fedcr/SmartCurtain/BOM.md

# SmartCurtain - Enclosure and Mechanical Transmission – bill of materials

<!-- Generated by Half Life from project cmv53qt9g0gqx01n0q0fv1dz5. Edits here are overwritten on the next sync. -->
<!-- Generated: 1970-01-01T00:00:00.000Z -->

> [!NOTE]
> This parts list is mirrored from [Half Life](https://halflife.hackclub.com). Editing it here will not change the platform's copy, and the next sync overwrites this file.

| Week | Tier | Parts funding |
| --- | --- | --- |
| Week 2 | Tier 1 | $30.00 |

_No parts listed yet._
