fedcr/SmartCurtain/BOM.csv

Item | Qty | Supplier | Cost/item | Total Cost | link
C3 | 1 |  | $2.09 | $2.09
C4 | 1 |  | $1.84 | $1.84
C5 | 1 |  | $0.00 | $0.00
C6 | 1 |  | $0.00 | $0.00
D1 | 1 |  | $1.32 | $1.32
J1 | 1 |  | $3.40 | $3.40
J2 | 1 |  | $3.67 | $3.67
J3 | 1 |  | $2.49 | $2.49
J5 | 1 |  | $2.81 | $2.81
LuceClima1 | 1 |  | $0.00 | $0.00
Q1 | 1 |  | $1.73 | $1.73
R2 | 1 |  | $1.88 | $1.88
R3 | 1 |  | $3.25 | $3.25
R4 | 1 |  | $0.00 | $0.00
R5 | 1 |  | $0.00 | $0.00
R6 | 1 |  | $0.00 | $0.00
R7 | 1 |  | $0.00 | $0.00
R8 | 1 |  | $0.00 | $0.00
RadarmmWave1 | 1 |  | $0.00 | $0.00
SW1 | 1 |  | $2.65 | $2.65
U1 | 1 |  | $5.86 | $5.86
U2 | 1 |  | $6.24 | $6.24
U3 | 1 |  | $4.29 | $4.29
U4 | 1 |  | $1.71 | $1.71
M1 | 1 |  | $8.00 | $8.00
PCB | 1 |  | $3.57 | $3.57
Estimated total shipping | 1 |  |  | $70.11
