fedcr/SmartCurtain/File STL/bracket4.stl

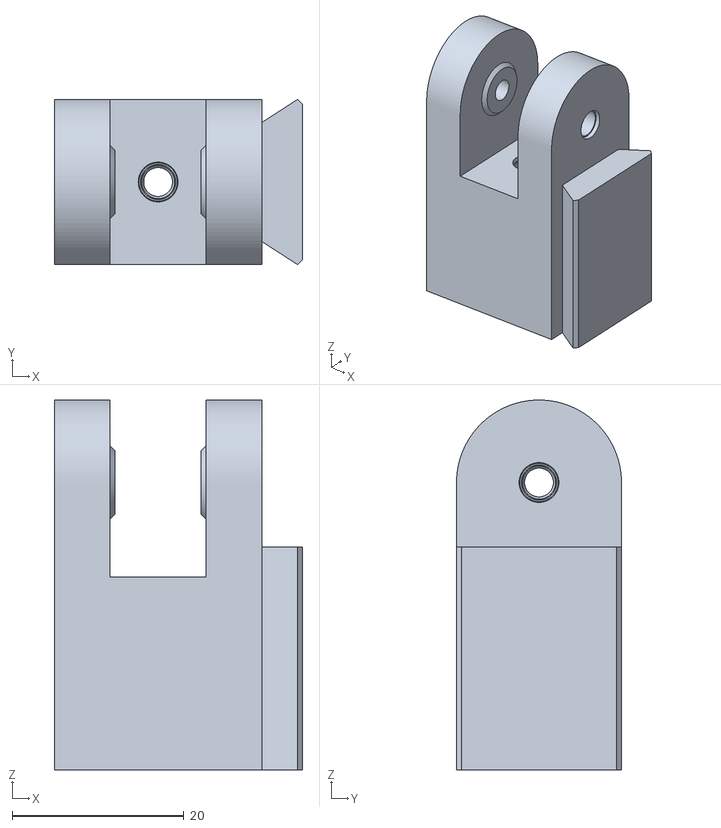
[picture p1: CAD file, 2026-10-14]
File STL/bracket4.stl
28.9 x 19.2 x 43.1
