fedcr/SmartCurtain/PCB/PCB.stl

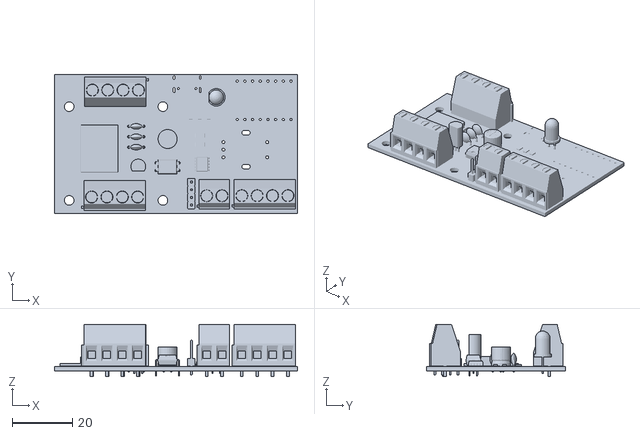
[picture p2: CAD file, 2026-10-21]
PCB/PCB.stl
80.4 x 46.0 x 17.3
