fedcr/SmartCurtain/Print Files/STL/smartcurtain_idler_sleeve.stl

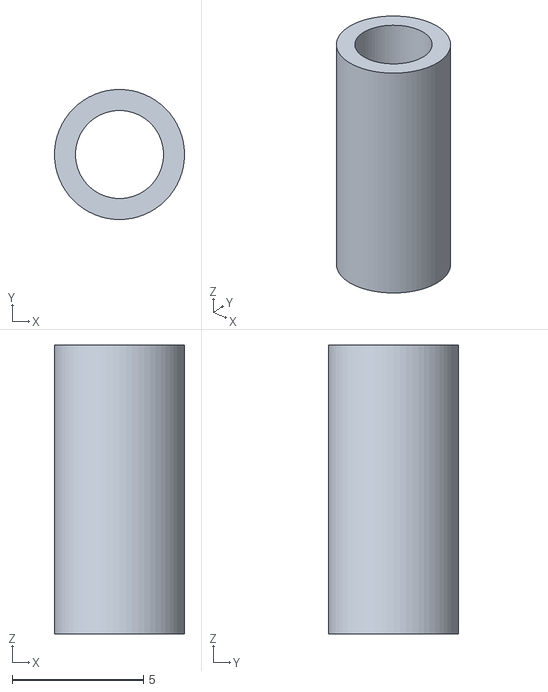
[picture p3: CAD file, 2026-10-21]
Print Files/STL/smartcurtain_idler_sleeve.stl
4.95 x 4.95 x 11.0
