fedcr/SmartCurtain/File STL/bracket1.stl

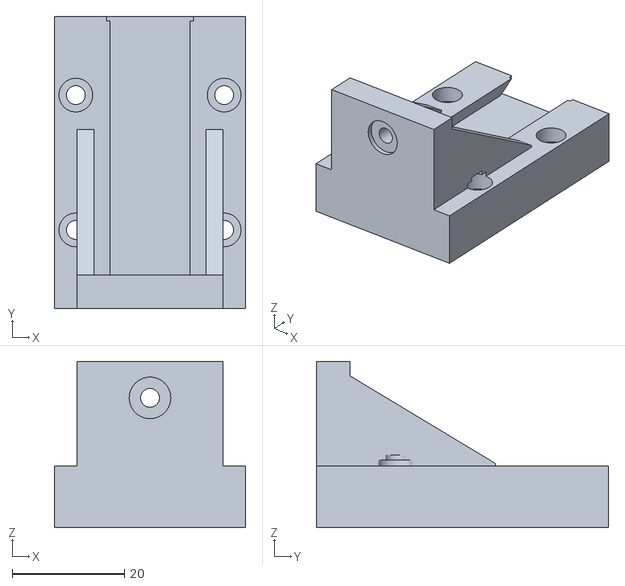
[picture p4: CAD file, 2026-10-14]
File STL/bracket1.stl
34.0 x 52.0 x 29.6
