fedcr/SmartCurtain/Print Files/STL/smartcurtain_trolley.stl

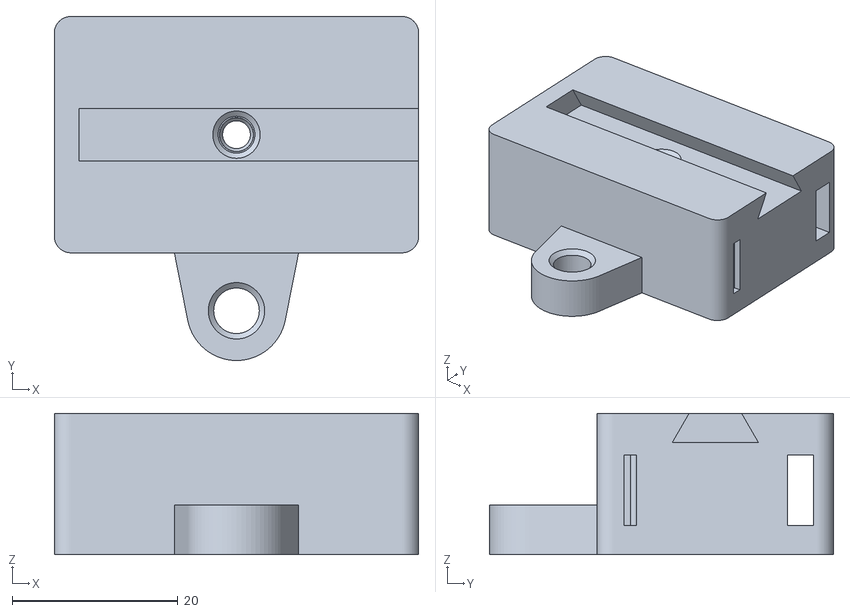
[picture p5: CAD file, 2026-10-21]
Print Files/STL/smartcurtain_trolley.stl
44.0 x 41.5 x 17.0
