fedcr/SmartCurtain/File STL/file puleggia.3mf

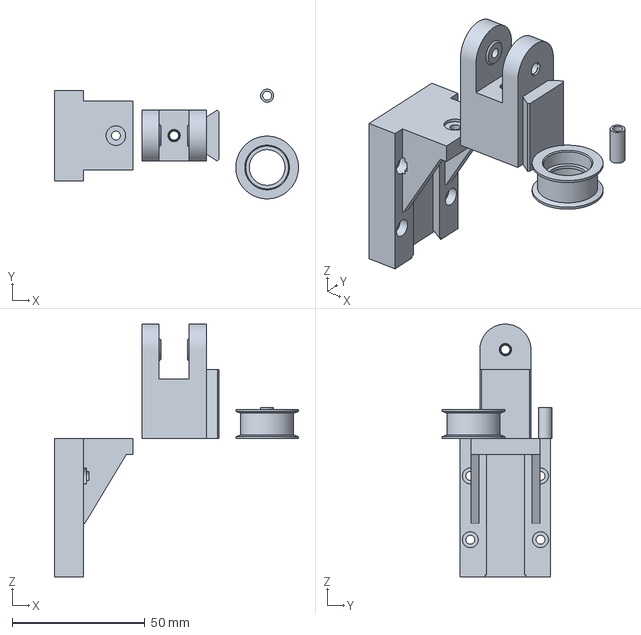
[picture p6: CAD file, 2026-10-14]
File STL/file puleggia.3mf
91.8 x 41.3 x 95.1 mm
