fedcr/SmartCurtain/Print Files/STL/smartcurtain_mmwave_mount.stl

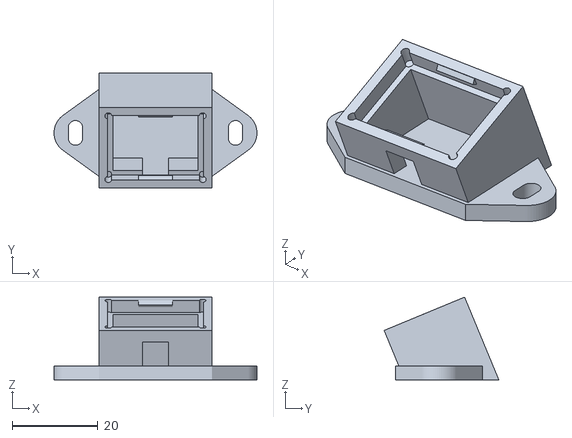
[picture p7: CAD file, 2026-10-21]
Print Files/STL/smartcurtain_mmwave_mount.stl
47.3 x 26.7 x 19.3
