fedcr/SmartCurtain/File STL/bracket2.stl

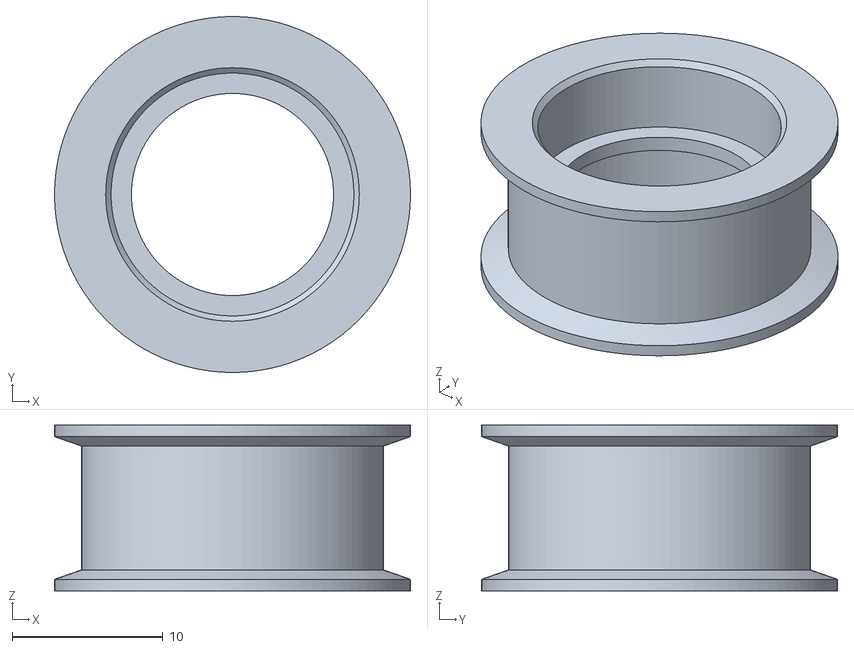
[picture p8: CAD file, 2026-10-14]
File STL/bracket2.stl
23.6 x 23.6 x 11.0
