fedcr/SmartCurtain/Print Files/STL/smartcurtain_pulley_coupon.stl

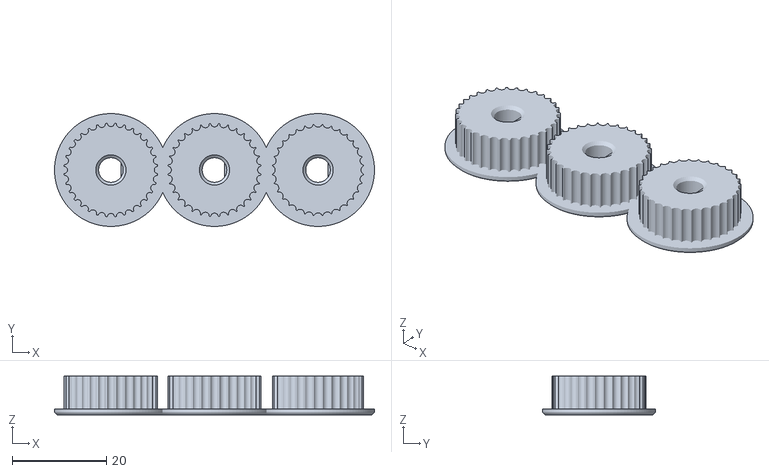
[picture p9: CAD file, 2026-10-21]
Print Files/STL/smartcurtain_pulley_coupon.stl
68.0 x 24.0 x 8.21
