fedcr/SmartCurtain/File STL/bracket3.stl

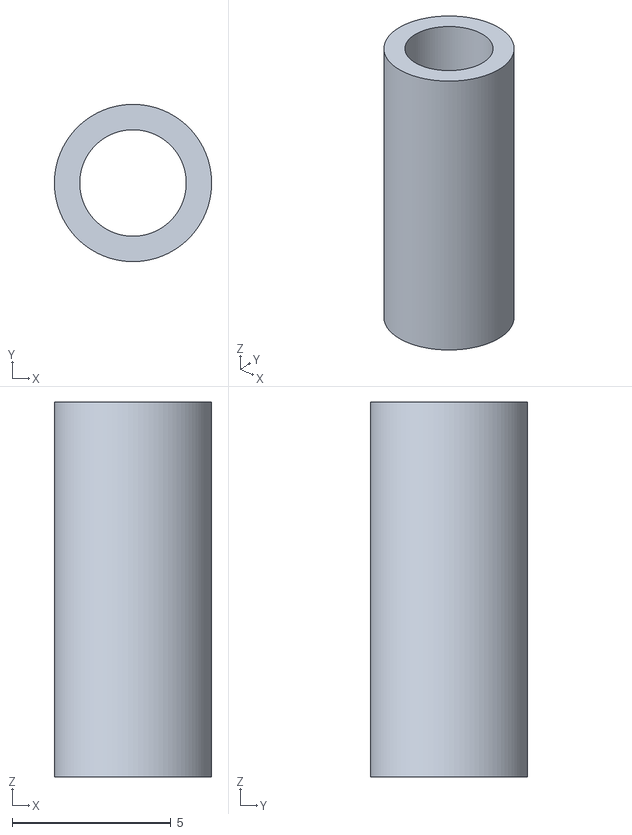
[picture p10: CAD file, 2026-10-14]
File STL/bracket3.stl
4.95 x 4.95 x 11.8
