fedcr/SmartCurtain/Print Files/STL/smartcurtain_idler_carriage.stl

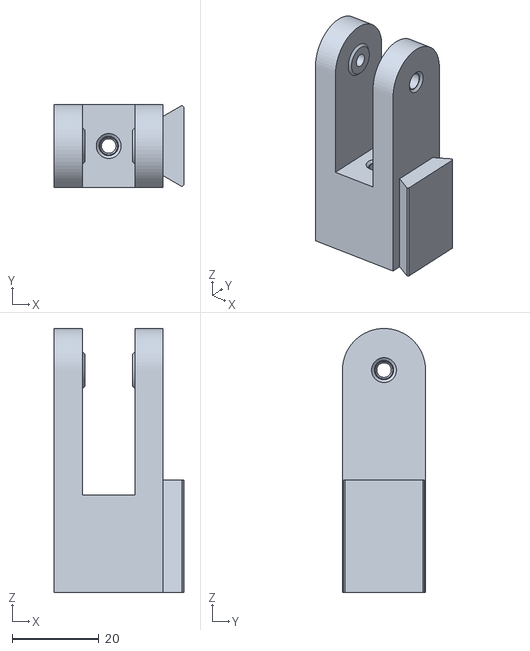
[picture p11: CAD file, 2026-10-21]
Print Files/STL/smartcurtain_idler_carriage.stl
30.0 x 19.2 x 61.0
