fedcr/SmartCurtain/Print Files/STL/smartcurtain_base.stl

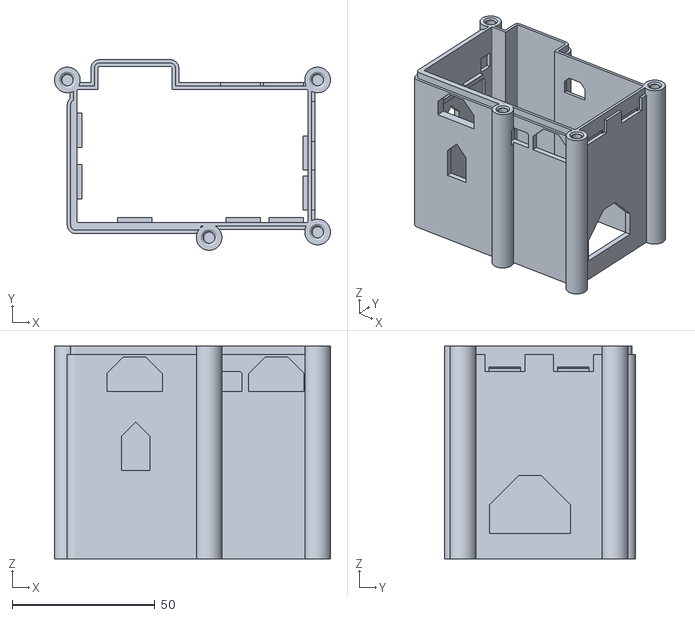
[picture p12: CAD file, 2026-10-21]
Print Files/STL/smartcurtain_base.stl
96.7 x 66.8 x 74.6
