fedcr/SmartCurtain/Print Files/STL/smartcurtain_ec11_knob.stl

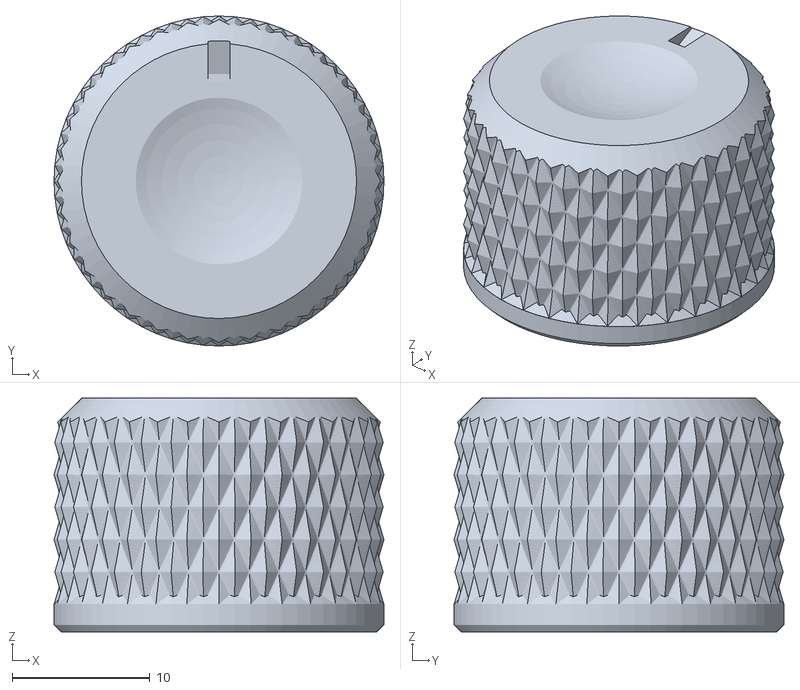
[picture p13: CAD file, 2026-10-18]
Print Files/STL/smartcurtain_ec11_knob.stl
24.0 x 24.0 x 17.0
