fedcr/SmartCurtain/Print Files/STL/smartcurtain_fit_test_coupon.stl

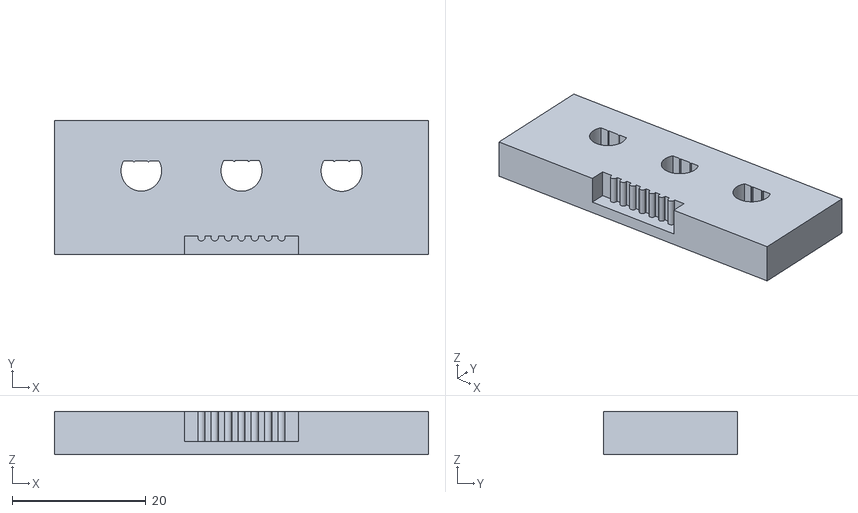
[picture p14: CAD file, 2026-10-18]
Print Files/STL/smartcurtain_fit_test_coupon.stl
56.0 x 20.0 x 6.50
