fedcr/SmartCurtain/Print Files/STL/smartcurtain_track_adapter.stl

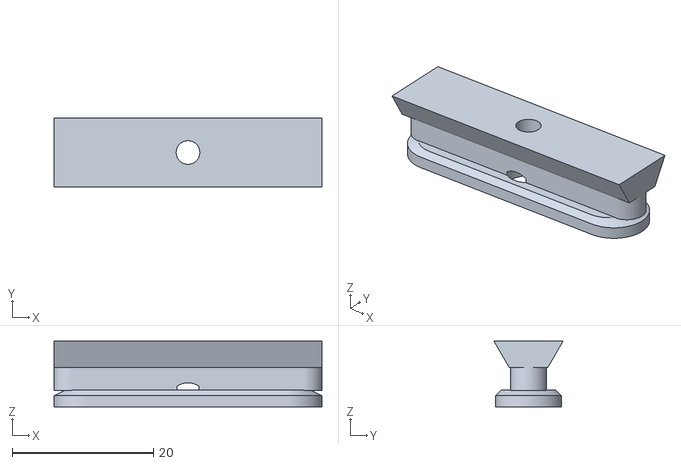
[picture p15: CAD file, 2026-10-18]
Print Files/STL/smartcurtain_track_adapter.stl
38.0 x 9.82 x 9.36
