fedcr/SmartCurtain/Print Files/STL/smartcurtain_lid.stl

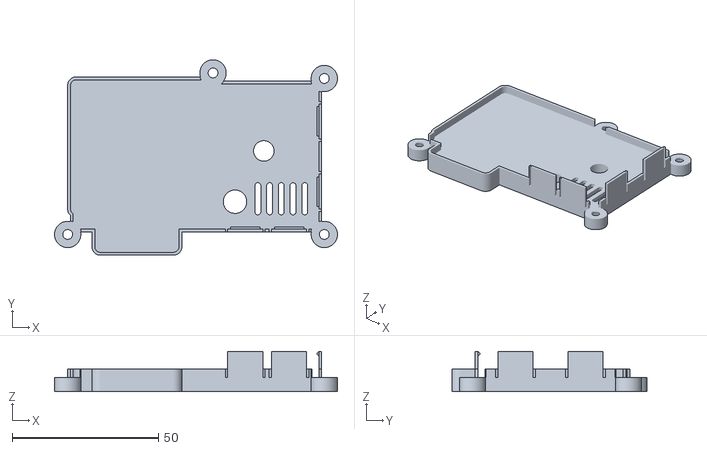
[picture p16: CAD file, 2026-10-18]
Print Files/STL/smartcurtain_lid.stl
96.7 x 66.8 x 13.8
