fedcr/SmartCurtain/Print Files/STL/smartcurtain_motor_tray.stl

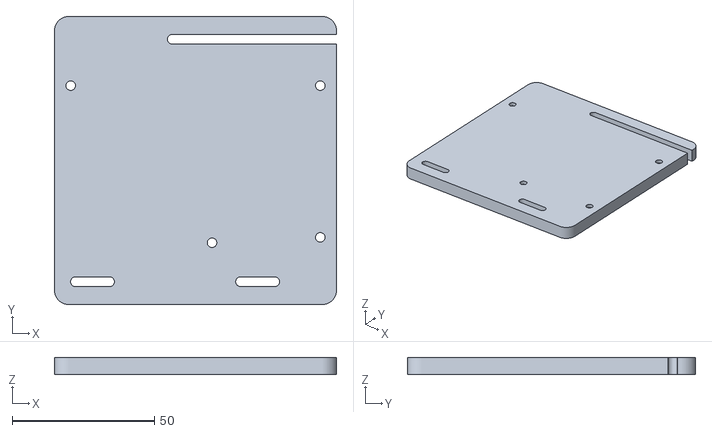
[picture p17: CAD file, 2026-10-18]
Print Files/STL/smartcurtain_motor_tray.stl
99.1 x 101.2 x 6.00
