fedcr/SmartCurtain/Print Files/STL/smartcurtain_mount_plate.stl

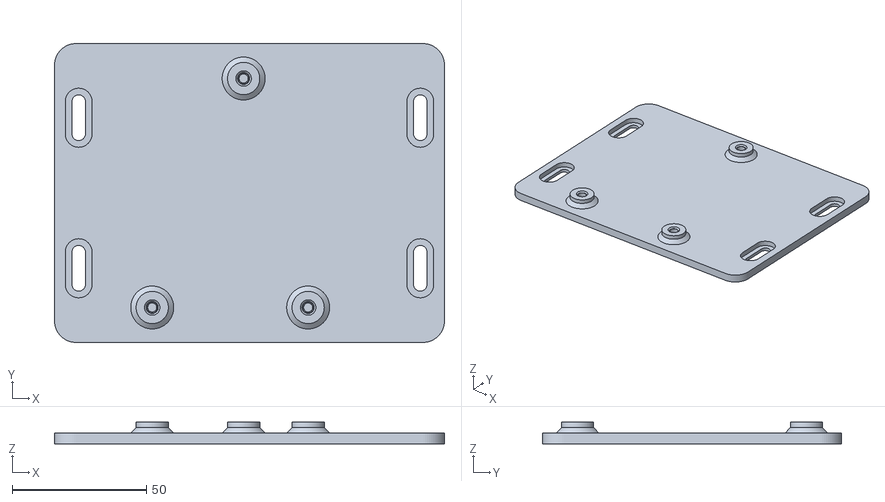
[picture p18: CAD file, 2026-10-18]
Print Files/STL/smartcurtain_mount_plate.stl
145.1 x 111.2 x 8.00
