fedcr/SmartCurtain/Print Files/STL/smartcurtain_drive_pulley.stl

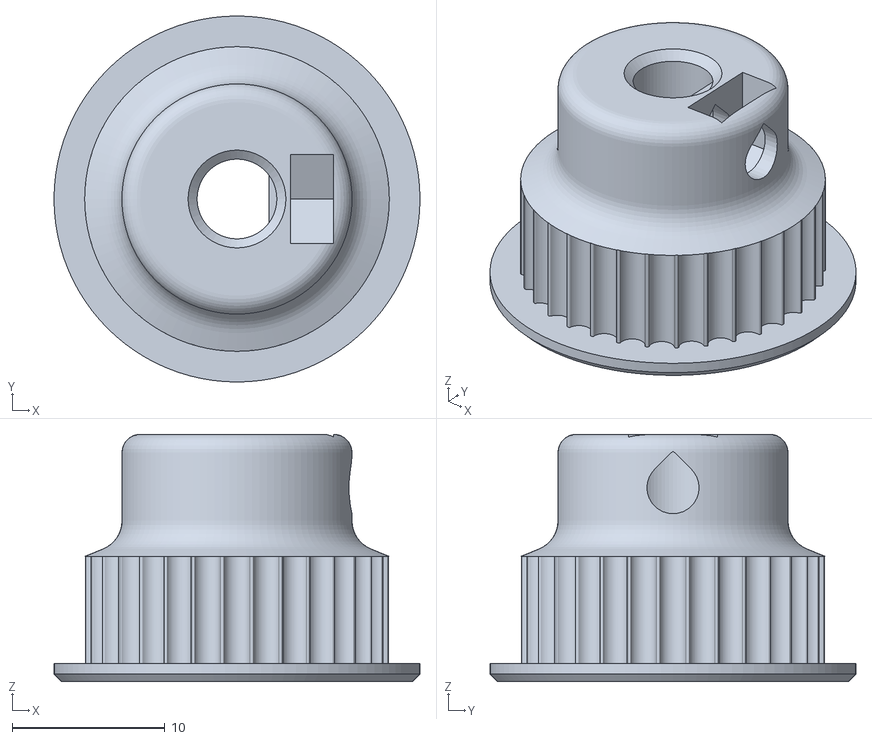
[picture p19: CAD file, 2026-10-18]
Print Files/STL/smartcurtain_drive_pulley.stl
24.0 x 24.0 x 16.2
