fedcr/SmartCurtain/Print Files/STL/smartcurtain_idler_bracket.stl

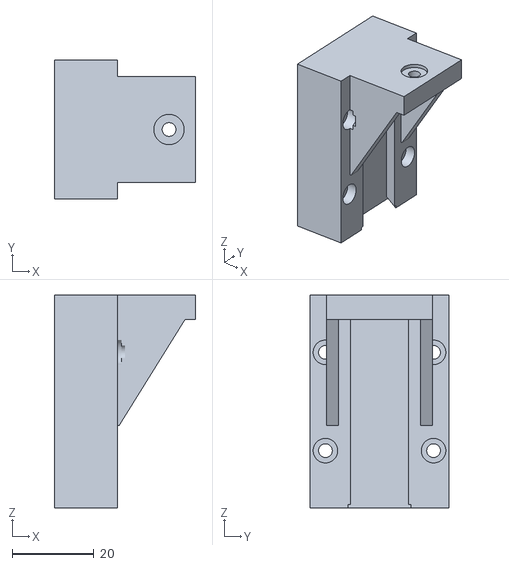
[picture p20: CAD file, 2026-10-18]
Print Files/STL/smartcurtain_idler_bracket.stl
34.5 x 34.0 x 52.0
