fedcr/SmartCurtain/(list of files, cad)

Other CAD files:
Print Files/STL/smartcurtain_idler_pulley.stl
File STL/smartcurtain_base.stl
File STL/smartcurtain_lid.stl
