fedcr/SmartCurtain/JOURNAL.md

# SmartCurtain – devlog

<!-- Generated by Half Life from project cmuv4sq3c0dhd01smz4r1cpfq. Edits here are overwritten on the next sync. -->
<!-- Generated: 2026-10-11T14:29:49.906Z -->

> [!NOTE]
> This devlog is mirrored from [Half Life](https://halflife.hackclub.com) – [open the project](https://halflife.hackclub.com/projects/cmuv4sq3c0dhd01smz4r1cpfq). Editing it here will not change the platform's copy, and the next sync overwrites this file.

> An ESP32 powered smart curtain driver designed to automate my home's curtains while acting as a moudular smart home node. It uses a stepper motor and has some screw moutings for extra "add-ons" as cancel opener, air conditioner command, tv command and a lot of other things

| Week | Tier | Hours logged | Entries |
| --- | --- | --- | --- |
| Week 1 | Tier 3 | 20h | 8 |

## Contents

1. [2026-10-06 – ## What I worked on](#2026-10-06-what-i-worked-on)
2. [2026-10-07 – ### What I worked on](#2026-10-07-what-i-worked-on)
3. [2026-10-08 – ### What I worked on](#2026-10-08-what-i-worked-on)
4. [2026-10-09 – ### What I worked on](#2026-10-09-what-i-worked-on)
5. [2026-10-09 – ### What I worked on](#2026-10-09-what-i-worked-on)
6. [2026-10-10 – ### What I worked on](#2026-10-10-what-i-worked-on)
7. [2026-10-11 – ### What I worked on](#2026-10-11-what-i-worked-on)
8. [2026-10-11 – ### What I worked on](#2026-10-11-what-i-worked-on)

## Design

### 2026-10-06 – ## What I worked on

**3h**

## What I worked on
Designed and finalized the complete hardware schematic for the SmartCurtain controller board, achieving a clean  ERC check and mapping all footprints.

- Integrated ESP32-C3-WROOM-02 with USBC-C input via CH224K sink controller (configured for 12V negotiation) and a Mini360 step-down buck converter to create the 3.3V logic rail
- Added socket headers for the TMC2209 StepStick driver with motor outputs on a 4pin screw terminal, plus dedicated bulk decoupling (100nF)
- Added ambient light and mmWave predisposition
- Added an EC11 rotary encoder for manual input
- Added a PC817 optocoupled output for external triggers and a NPNdriver IR emitter circuit
- Paired every component with his footprints



## What broke and how I fixed it

- Resolved power net issues where simulation SPICE NPN models caused open emitter /power output ERC errors by swapping to standard KiCad device symbols
- Corrected strapping pin IO9 on the ESP32 (removed floating ground to prevent bootloader lockup)
- Fixed reversed polarity problems on the LED
- Isolated 12v and 3.3V power flags to avoid virtual net shorts



## Next steps
Design the pcb by defining the board outline, arranging footprints and beginning routing traces



### 2026-10-07 – ### What I worked on

**4h**

### What I worked on
Completed the full component placement and traced routing for the SmartCurtain controller board on KiCad, finalizing the PCB ready for fabrication.

### Schematic
- Added M3 Holes for PCB mounting
- Swapped to the full 16 pin dual row footprint for the TMC2209 module to eliminate footprint mismatches



### Board Layout
- Positioned the ESP32-C3-WROOM-02 along the board edge, keeping the integrated PCB antenna on the edge
- Aligned all peripheral screw terminals (stepper motor, mmWave radar, light or climate sensor, external triggers...) along the outer perimeter with wire entries facing outwards for clean enclosure passthrough
- Fixed connector clearences in USBC
- Placed the 4x M3 mounting holes away from component housing with the idea to screw them with the stepper motor

### Routing
Initially attempted manual routing, but given the board density and multiple voltage domains, tried running Freerouting as a starting point.
Freerouting handled roughly 20-30% of the initial digital connections, but introduced severe design flaws creating many mistakes (excessive vias, routed high current 12V motor traces with 0.2mm signal widths, and left several uncompleted ratlines).
When reimported into KiCad, the initial DRC flagged over 50 clearence and net violations



### What broke and how I fixed it
- Rerouted 70-80% of the board manually (fixing the errors made by Freerouting(
- Defined custom 0.6mm traces for 12V and 0.4mm for 3.3V
- Resolved `[drill_out_of_range]` errors caused by the default 0.3mm minimum drill with the ESP32 ground path vias by updating board design rules
- Fixed `[copper_edge_clearance]` by tuning Edge.Cuts board outline clearances
- Achived a perfectly clean DRC report with 0 violations, 0 unconnected pads and 0 footprint errors



### 3D View







### 2026-10-08 – ### What I worked on

**2h**

### What I worked on
Enhanced the SmartCurtain PCB aesthetics and user serviceability by designing custom project branding and refining all silkscreen identification

### Custom vector branding
- hand sketched and vectorized a custom project emblem representing SmartCurtain
- imported and worked on the graphic in Canva, exporting .svg file
- positioned the logo on the silkscreen in KiCad





### Silkscreen pinout and legends
- added labeling texts
- cleaned refence placement
- ensured that no text collides with exposed solder mask on component pads



### What broke and how I fixed it
- repositioned tight silkscreen around the dense pcb to ensure clearance from pad rings

### Next steps
Proceed with file generation (GERBER, Drill, P&P...), verificate in gerber  viewer and draft the bill of material

### 2026-10-09 – ### What I worked on

**2.5h**

### What I worked on
Conducted electrical trace sizing and thermal validation for the SmartCurtain controller board using KiCad's integrated calculation suite

### Trace Verification
  - Simulated thermal rise under full stepper motor load (1.5A continuous peak current) with standard 1oz (35µm) copper foil thickness.
  - Calculated that an external trace width of 0.525mm results in a conservative temperature rise of only 10°C, a loop resistance of ~0.046Ω, and an insignificant voltage drop of ~0.07V over 50mm.
  - Validated our physical board design: our manual routing of 0.8mm for primary motor supply lines provides a 52% safety margin over IPC-2221 minimums.
- **Electrical Clearance & Creepage:**
  - Evaluated high-voltage insulation tables for USB-C PD 12V-20V potential transients. Verified that our 0.20mm routing clearance comfortably exceeds the required 0.10mm minimum conductor spacing (B2 external conductors).







### What broke and how I fixed it
- Discovered an internal-layer routing risk where Freerouting originally attempted to route high-current lines: IPC-2221 calculations revealed that internal traces require 1.367mm width to maintain the same 10°C temperature limit. Ensured all motor coil power traces reside strictly on external copper layers

### 2026-10-09 – ### What I worked on

**2.5h**

### What I worked on
Prepared the complete automated assembly package directly within KiCad.

### Component Placement Data
  - Exported unified centroid coordinate files containing precise footprint center coordinates, package types, and rotation angles.
  - Calibrated the dedicated Drill & Place Origin point to the bottom-left board corner (datum 0,0), preventing offset mismatch during automated SMT placement.
  - Verified component rotation conventions for polarized parts (CH224K pin 1, C3 electrolytic orientation, USB-C receptacle).
- **Mechanical Dimensioning & Constraints (`Dwgs.User`):**
  - Added exact CAD reference dimensions for the enclosure team: measured overall PCB footprint (79.17mm x 45.29mm), exact mounting hole pitch between M3 standoffs, and connector overhang offsets.



### What broke and how I fixed it
- Fixed component angle misalignment where SMD passives exported with 180° rotation offsets relative to standard tape-and-reel feeders; aligned component reference orientations to match standard requirements.

### Next steps
Submit the finalized files for PCB fabrication, close Week 1 milestones, and begin 3D CAD modeling of the motorized curtain transmission in Week 2.





### 2026-10-10 – ### What I worked on

**2h**

### What I worked on
Solder stencil generation, solder paste aperture optimization, and multi-layer CAM optical inspection.

### Solder Paste Mask Optimization
  - Generated dedicated solder stencil fabrication layers in KiCad Pcbnew.
  - Adjusted global and pad-level paste mask reduction ratios: applied a 10% area reduction (-0.05mm clearance) across the dense 0.5mm-pitch pads of the CH224K SSOP-10 package and USB-C SMD pins. This prevents excessive solder paste deposition, eliminating the risk of accidental solder bridges during hot-plate/reflow soldering.



### GerbView
  - Conducted full cross-layer alignment checks in GerbView with differential color overlays.
  - Verified solder mask expansion clearances (set to 0.05mm) against copper pad annular rings, ensuring complete solder dam preservation between closely spaced passive 0805 components.



### 2026-10-11 – ### What I worked on

**3h**

### What I worked on
Finalized the repository release deliverables by structuring the complete Bill of Materials and writing the .io firmware with Home Assistant integration.

### BOM Standardization and portal ingestion
  - Standardized the component database in `SmartCurtain_BOM.csv' to match portal parser conventions, converting European decimal commas into clean floats, removing unparsed currency symbols, and mapping explicit vendor fields.
  - Successfully imported all 24 line items with verified pricing and footprint assignments for automated evaluation.



### README
  - Authored a comprehensive project README covering the system architecture and the scope

### Arduino firmware and Home Assistant Integration (Partially Vibecoded)
  - Developed the core ESP32-C3 C++ control firmware utilizing `WiFi.h` and `PubSubClient`.
  - Implemented non-blocking step generation for the TMC2209 driver, enabling full open, full close, and percentage-based partial positioning.
  - Added physical input handling via EC11 rotary encoder polling and push-button toggling with software debounce.
  - Set up optional peripheral reads (mmWave radar presence pin and PC817 optocoupled trigger) without locking motor execution if external sensors are disconnected.
  - Authored companion Home Assistant `configuration.yaml` definitions for auto-discovery and manual MQTT entity configuration.















### 2026-10-11 – ### What I worked on

**1h**

### What I worked on
Implemented non-volatile flash storage handling and power-cycle recovery routines in the ESP32-C3 firmware to prevent mechanical desynchronization.

- Integrated the ESP32 `` library to persistently store the curtain's absolute step position (`currentPosition`) in onboard flash memory partition.
  - Implemented an automatic boot restoration routine: on startup, the firmware reads the last saved step value from NVS before enabling the TMC2209 driver, ensuring the controller knows whether the curtain is open, closed, or partially positioned across power cycles without needing a manual homing sequence.
  - Added flash write-endurance protection: instead of writing to flash on every individual motor step (which would wear out flash sectors), implemented an idle-commit timer that writes to NVS only after the motor has remained stationary for 3 seconds.







### What broke and how I fixed it
- Realized that simulating a power outage left `currentPosition` reset to 0 in RAM; if the curtain was physically closed, a subsequent "CLOSE" command would drive the stepper beyond its physical rail limit and stall the motor. Resolving this via NVS recovery safeguards the mechanical track and belt transmission.

### Next steps
Conclude Week 1 milestone submissions with all 20 hours logged and transition to Week 2 3D modeling of the motor mount and belt drive pulleys.
