fedcr/SmartCurtain/PCB/SmartCurtain.kicad_pcb

## KiCad design PCB/SmartCurtain.kicad_pcb (2026-10-21)

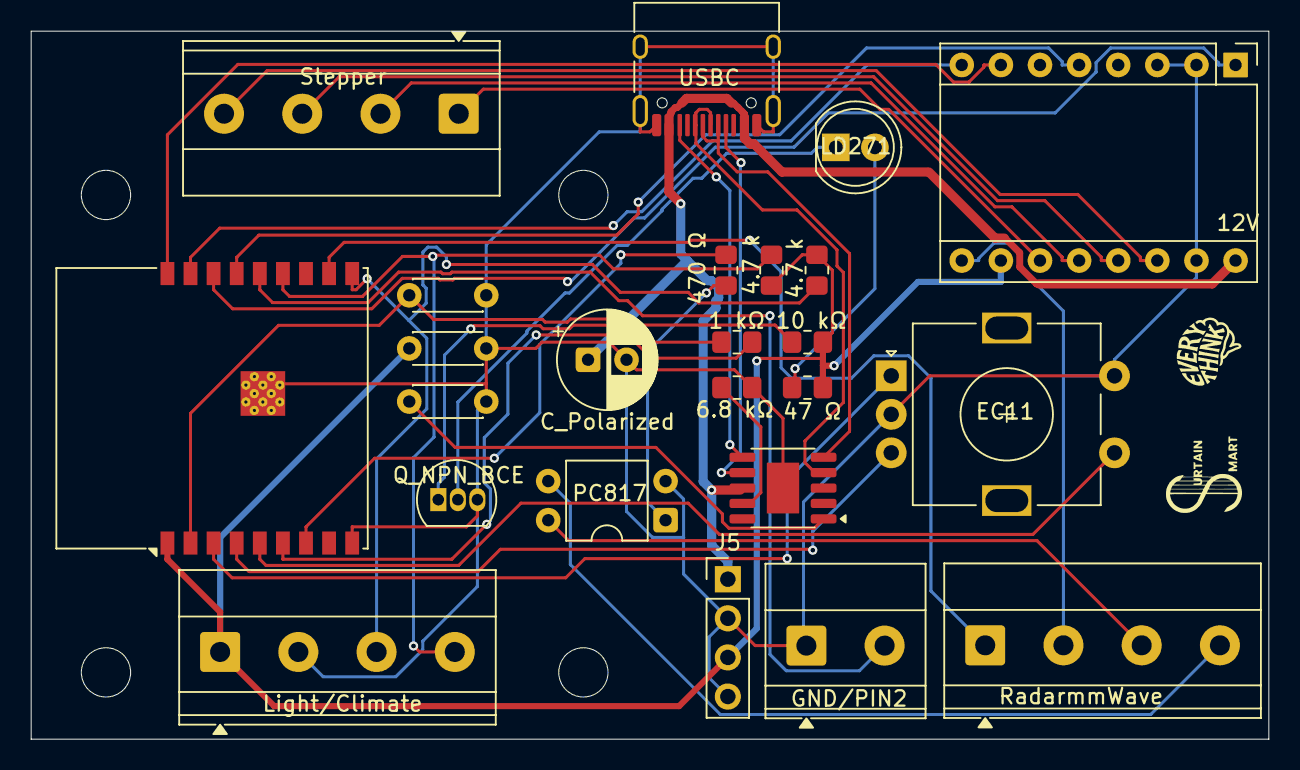
[picture p21: board SmartCurtain.kicad_pcb from above]

Board: 2 copper layers, 80.4 x 46.0 mm, 28 parts (0 on the bottom side), 33 nets.

Parts:
1 kΩ: 1 kΩ; R_0805_2012Metric_Pad1.20x1.40mm_HandSolder
4.7 k, 4.7 k#2: 4.7 k; R_0805_2012Metric_Pad1.20x1.40mm_HandSolder
6.8 kΩ: 6.8 kΩ; R_0805_2012Metric_Pad1.20x1.40mm_HandSolder
10 kΩ: 10 kΩ; R_0805_2012Metric_Pad1.20x1.40mm_HandSolder
47 Ω: 22 Ω - 47 Ω; R_0805_2012Metric_Pad1.20x1.40mm_HandSolder
470 Ω: 470 Ω; R_0805_2012Metric_Pad1.20x1.40mm_HandSolder
C4, C6: C; C_Disc_D4.3mm_W1.9mm_P5.00mm
C5: 100nF; C_Disc_D4.3mm_W1.9mm_P5.00mm
C_Polarized: C_Polarized; CP_Radial_D6.3mm_P2.50mm
EC11: RotaryEncoder_Switch; RotaryEncoder_Alps_EC11E-Switch_Vertical_H20mm
H1, H2, H3, H4: MountingHole; MountingHole_3.2mm_M3
J1: Stepper; TerminalBlock_Phoenix_MKDS-1,5-4-5.08_1x04_P5.08mm_Horizont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
J5: Mini360_Buck; PinHeader_1x04_P2.54mm_Vertical
LD271: LD271; LED_D5.0mm_IRGrey
Light/Climate: Screw_Terminal_01x04; TerminalBlock_Phoenix_MKDS-1,5-4-5.08_1x04_P5.08mm_Horizont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
Q1: Q_NPN_BCE; TO-92L_Inline
RadarmmWave: Screw_Terminal_01x02; TerminalBlock_Phoenix_MKDS-1,5-2-5.08_1x02_P5.08mm_Horizont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
RadarmmWave1: Screw_Terminal_01x04; TerminalBlock_Phoenix_MKDS-1,5-4-5.08_1x04_P5.08mm_Horizont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
U1: ESP32-C3-WROOM-02
U2: CH224K; SSOP-10-1EP_3.9x4.9mm_P1mm_EP2.1x3.3mm
U3: TMC2209_StepStick; Pololu_Breakout-16_15.2x20.3mm
U4: PC817; DIP-4_W7.62mm
USBC: USB_C_Receptacle_USB2.0_16P; USB_C_Receptacle_HRO_TYPE-C-31-M-12

Connections:
+3V3: 4.7 k.1, 4.7 k#2.2, 10 kΩ.1, 47 Ω.1, C5.1, J5.3, Light/Climate.1, U1.1 (3V3), U3.10 (VIO)
+12V: C_Polarized.1, J5.1, U2.8 (VBUS), U3.16 (VMOT), USBC.A4 (VBUS), USBC.A9 (VBUS), USBC.B4 (VBUS), USBC.B9 (VBUS)
GND: 6.8 kΩ.1, C4.2, C5.2, C6.2, C_Polarized.2, EC11.C, EC11.S2, J5.2, J5.4, Light/Climate.2, Q1.3 (E), RadarmmWave.1, RadarmmWave1.2, U1.9 (GND), U1.19 (GND), U2.11 (GND), U3.2 (MS1), U3.3 (MS2), U3.9 (GND), U3.15 (GND_MOT), U4.2, USBC.A1 (GND), USBC.A12 (GND), USBC.B1 (GND), USBC.B12 (GND), USBC.SH (SHIELD)
unnamed: 47 Ω.2, LD271.2 (A)
unnamed: LD271.1 (K), Q1.2 (C)
unnamed: J1.1, U3.11 (1B)
unnamed: J1.2, U3.12 (1A)
unnamed: J1.3, U3.13 (2A)
unnamed: J1.4, U3.14 (2B)
unnamed: U2.7 (CC1), USBC.A5 (CC1)
unnamed: U2.6 (CC2), USBC.B5 (CC2)
unnamed: RadarmmWave.2, U1.14 (IO19)
unnamed: 4.7 k#2.1, Light/Climate.3, U1.10 (IO10)
unnamed: 4.7 k.2, Light/Climate.4, U1.13 (IO18)
unnamed: 1 kΩ.2, Q1.1 (B)
unnamed: 470 Ω.1, U4.1
unnamed: RadarmmWave1.1, U1.11 (IO20/RXD)
unnamed: RadarmmWave1.3, U4.4
unnamed: RadarmmWave1.4, U4.3
unnamed: 10 kΩ.2, C4.1, U1.2 (EN)
unnamed: U1.18 (IO0), U3.7 (STEP)
unnamed: U1.17 (IO1), U3.8 (DIR)
unnamed: U1.16 (IO2), U3.1 (EN)
unnamed: U1.15 (IO3), U3.5 (DIAG)
unnamed: EC11.A, U1.3 (IO4)
unnamed: EC11.B, U1.4 (IO5)
unnamed: EC11.S1, U1.5 (IO6)
unnamed: 1 kΩ.1, U1.6 (IO7)
unnamed: 470 Ω.2, U1.7 (IO8)
unnamed: 6.8 kΩ.2, U2.9 (CFG1)
unnamed: U2.5 (DM), USBC.A7 (D-), USBC.B7 (D-)
unnamed: U2.4 (DP), USBC.A6 (D+), USBC.B6 (D+)
unnamed: C6.1, U2.1 (VDD)
