fedcr/SmartCurtain/(commit log)

2026-10-07 Uploading new files and new version of the old ones
    [SmartCurtain.kicad_pcb, SmartCurtain.kicad_sch]
2026-10-09 Uploading the updated project's files and GERBER file
    [SmartCurtain.kicad_pcb]
2026-10-11 Added Bill of Material and Pick & Place files
2026-10-11 Add price column to SmartCurtain BOM
    Added price information for components in BOM.
2026-10-11 Revise SmartCurtain BOM with vendor details
    Updated BOM to include vendor information and corrected prices.
2026-10-11 Revise SmartCurtain BOM with new values and prices
    Updated component values and prices in the BOM.
2026-10-12 Sync SmartCurtain - Enclosure and Mechanical Transmission from Half Life
